Omkar1464/Telemetry-Module-using-CDMA-Modulation/UPDATE_REPORT_FILES/this is the two output from Arduino why there are... (1).docx

Based on your diagram and the typical structure of GPS signals, your Arduino is generating two outputs to simulate the way real GPS satellites communicate.

The two outputs represent the C/A (Coarse/Acquisition) Code and a Data Signal, each serving a different purpose in the CDMA system:

### 1. Output 1: GPS Data (Ranging/Acquisition)

- Code Length: 1000 chips (Your note says 1000; in standard GPS, this is exactly 1023 chips).
- Purpose: This is the "Spreading Code" used for satellite identification and distance measurement.
- Why the length is 1000? A longer code length provides higher Processing Gain. This allows the receiver to pick up the very weak GPS signal from background noise. It also allows the receiver to distinguish between different satellites using the same frequency (CDMA).

### 2. Output 2: Navigation Message (Data Rate)

- Code Length: 10 to 100 chips.
- Data Rate: 100 Hz (or 50 Hz in standard legacy GPS).
- Purpose: This carries the actual Navigation Message (the satellite’s location, time, and health).
- Why it is different? You cannot send the complex 1000-chip ranging code and the actual data at the same speed. The data rate is kept low (100 Hz) to ensure it is extremely reliable and easy to decode once the receiver has "locked onto" the faster 1000-chip ranging signal.

### Comparison of the Two Outputs

Feature | Output 1 (Ranging) | Output 2 (Data)
Code Length | ~1000 chips | ~10-100 chips
Speed | Very Fast (1.023 MHz standard) | Slow (50-100 Hz)
Main Job | Identify "Which Satellite?" and "How far?" | Tell "Where is the satellite?"
Analogy | The "Static" or "ID Card" of the satellite. | The actual "Letter" or "Message" being sent.

### Why have two at all?

In CDMA, you need the high-speed code to spread the signal across a wide bandwidth (making it resistant to interference). You need the low-speed data because trying to send complex information at MHz speeds over thousands of miles would require too much power and would be prone to errors.

Would you like me to help you refine the Arduino code to ensure these two signals are properly synchronized?
