Omkar1464/Telemetry-Module-using-CDMA-Modulation/UPDATE_REPORT_FILES/G48- Update-LO Simulation _20260129_132546_0000.pdf

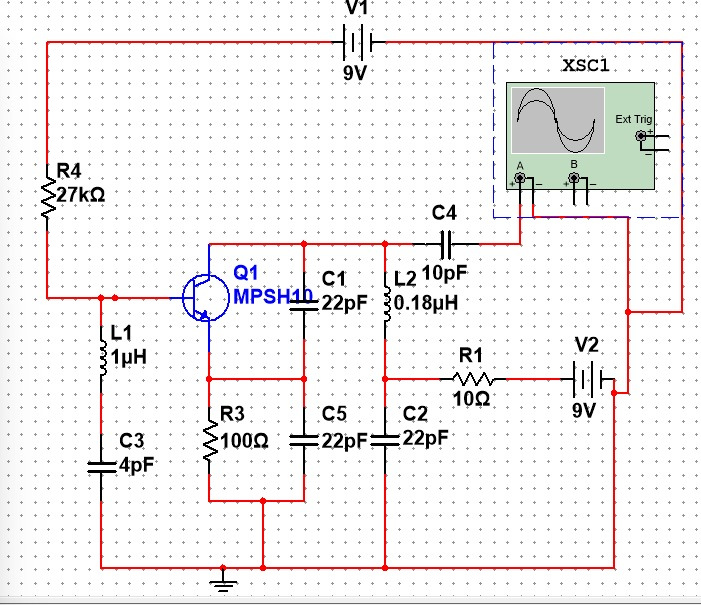
[picture p2: figure]

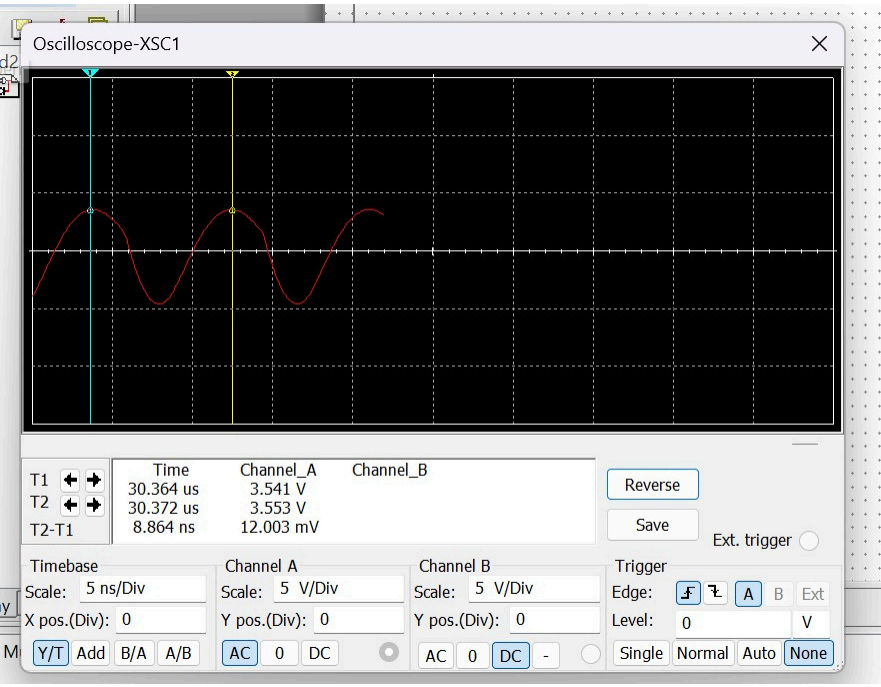
[picture p3: figure]
