Omkar1464/Telemetry-Module-using-CDMA-Modulation/BF998 MOSFET LIB/BF998.step

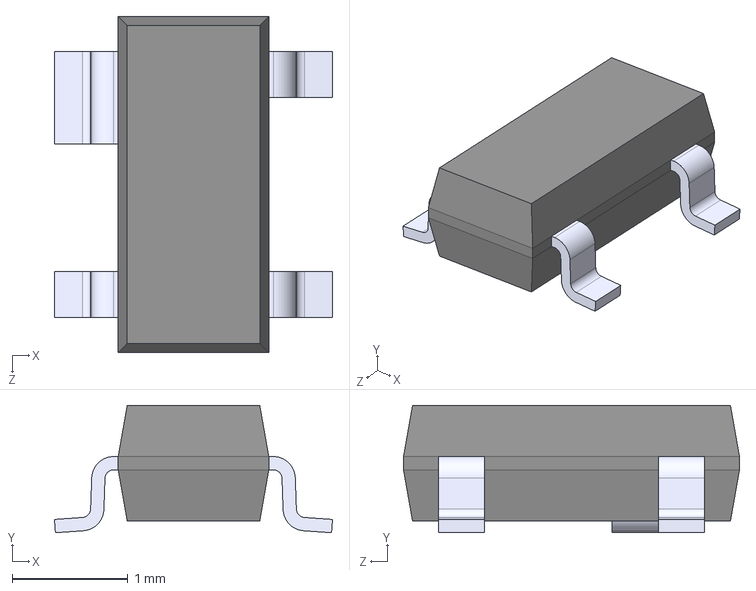
[picture p4: CAD file, 2026-02-17]
BF998 MOSFET LIB/BF998.step
2.40 x 1.10 x 2.90 mm
