Omkar1464/Telemetry-Module-using-CDMA-Modulation/PCB/POWER_MICROCONTROLLER/power circuit _new/MT3608/MT3608.step

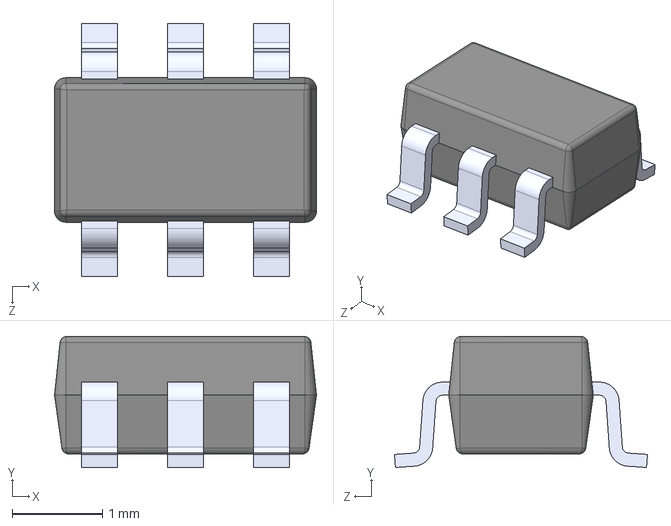
[picture p5: CAD file, 2026-10-12]
PCB/POWER_MICROCONTROLLER/power circuit _new/MT3608/MT3608.step
2.90 x 1.45 x 2.80 mm
