Omkar1464/Telemetry-Module-using-CDMA-Modulation/PCB/POWER_MICROCONTROLLER/power circuit _new/STM32G071RBT6/STM32G071RBT6.step

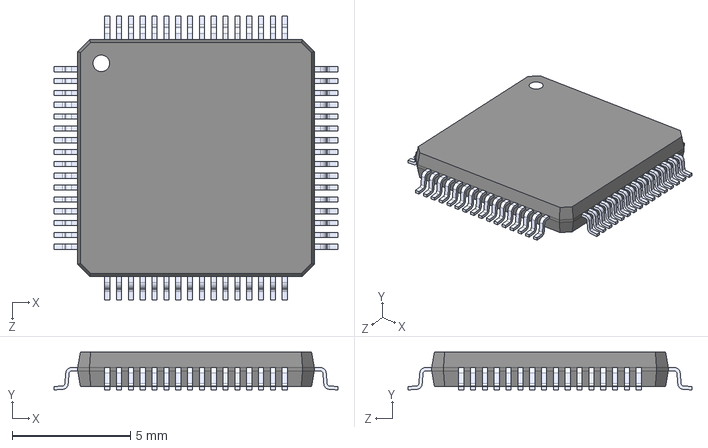
[picture p6: CAD file, 2026-10-12]
PCB/POWER_MICROCONTROLLER/power circuit _new/STM32G071RBT6/STM32G071RBT6.step
12.0 x 1.60 x 12.0 mm
