Omkar1464/Telemetry-Module-using-CDMA-Modulation/(list of files, drawings)

Other design files:
d2.ms14
Design1.ms14
L_oscillator.ms14
