Omkar1464/Telemetry-Module-using-CDMA-Modulation/PCB/POWER_MICROCONTROLLER/power circuit _new/power circuit _new.kicad_pcb

## KiCad design PCB/POWER_MICROCONTROLLER/power circuit _new/power circuit _new.kicad_pcb (2026-10-12)

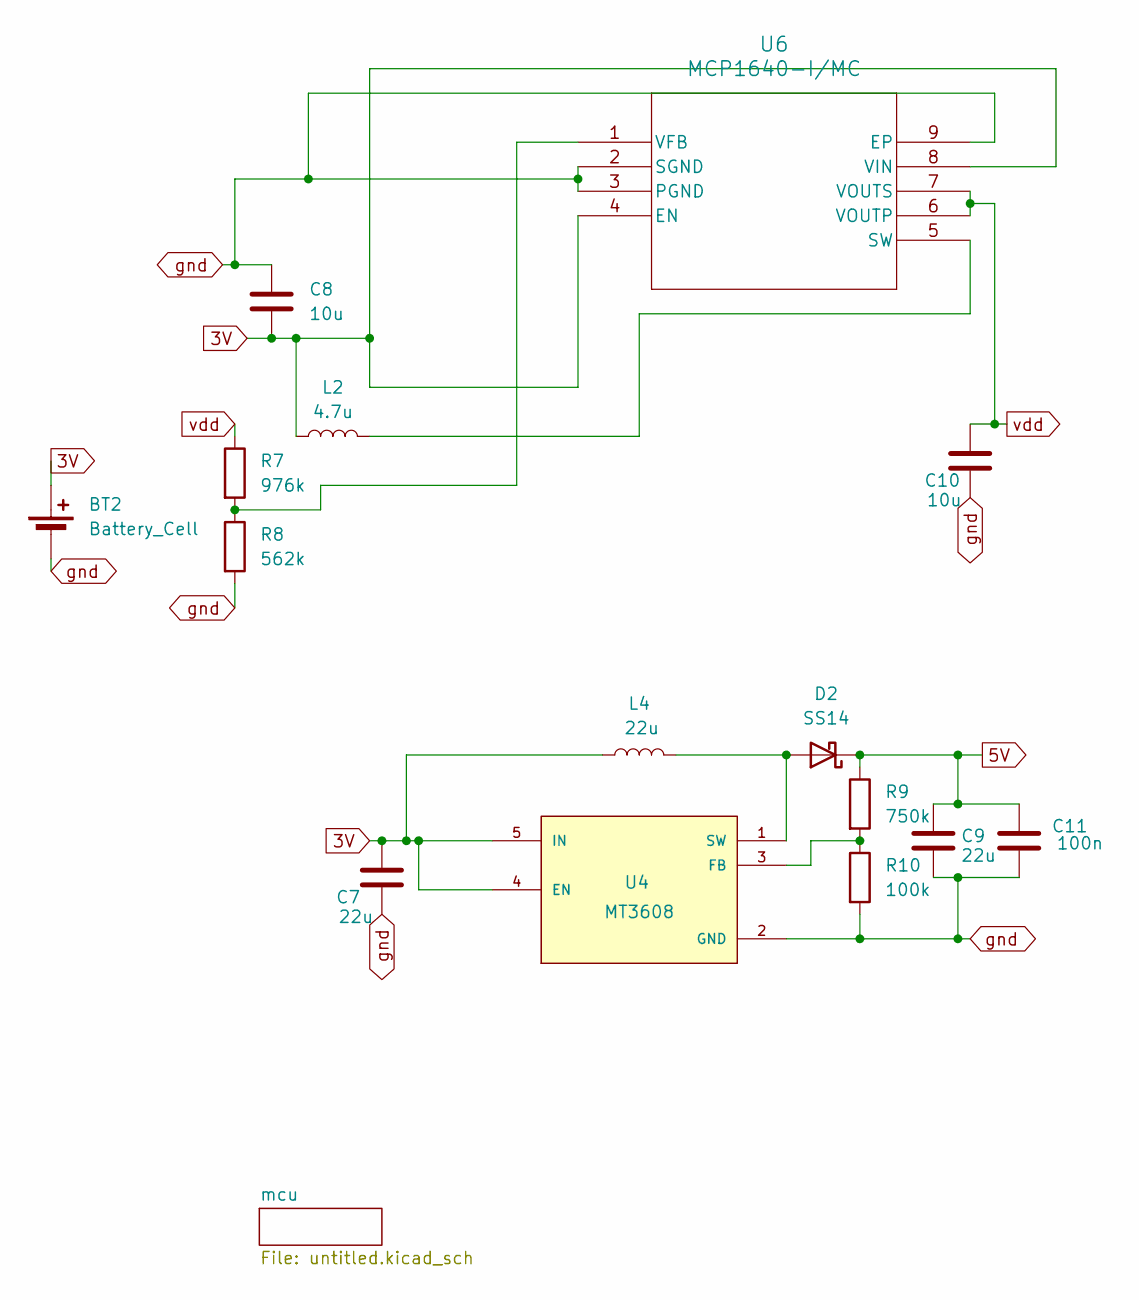
[picture p7: schematic power circuit _new.kicad_sch]

Parts:
BT2: Battery_Cell; SolderWire-0.25sqmm_1x02_P4.2mm_D0.65mm_OD1.7mm_Relief2x
C7, C9: 22u; C_0603_1608Metric
C8, C10: 10u; C_0603_1608Metric
C11: 100n; C_0603_1608Metric
D2: SS14; D_SMA
L2: 4.7u; L_0603_1608Metric
L4: 22u; L_0603_1608Metric
R7: 976k; R_0603_1608Metric
R8: 562k; R_0603_1608Metric
R9: 750k; R_0603_1608Metric
R10: 100k; R_0603_1608Metric
U4: MT3608; SOT95P280X145-6N; PARTREV 1.0
U6: MCP1640-I/MC; DFN8_2x3MC_MCH

Connections:
3V: BT2.1 (+), C7.1, C8.1, L2.1, L4.1, U4.4 (EN), U4.5 (IN), U6.4 (EN), U6.8 (VIN)
5V: C9.1, C11.1, D2.1 (K), R9.1
unnamed: D2.2 (A), L4.2, U4.1 (SW)
unnamed: R9.2, R10.1, U4.3 (FB)
unnamed: L2.2, U6.5 (SW)
unnamed: R7.2, R8.1, U6.1 (VFB)
gnd: BT2.2 (-), C7.2, C8.2, C9.2, C10.2, C11.2, R8.2, R10.2, U4.2 (GND), U6.2 (SGND), U6.3 (PGND), U6.9 (EP); also elsewhere on the board
vdd: C10.1, R7.1, U6.6 (VOUTP), U6.7 (VOUTS); also elsewhere on the board

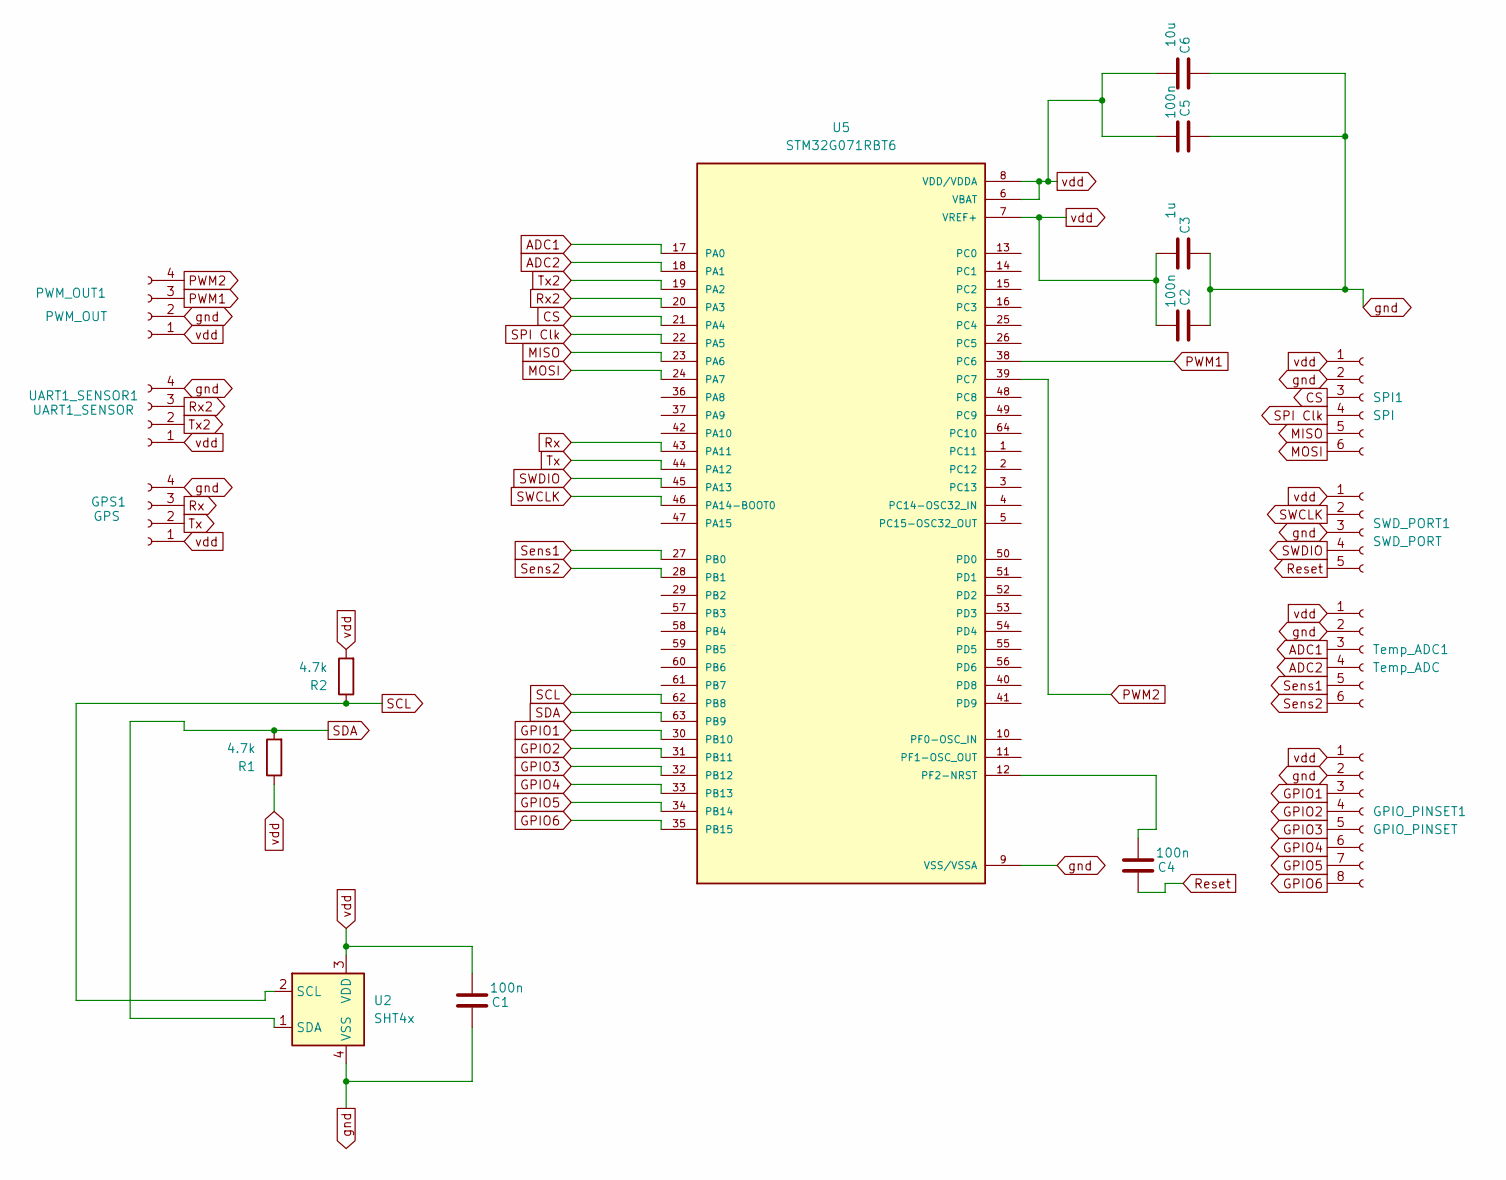
[picture p8: schematic untitled.kicad_sch]

Parts:
C1, C2, C4, C5: 100n; C_0603_1608Metric
C3: 1u; C_0603_1608Metric
C6: 10u; C_0603_1608Metric
GPIO_PINSET1: GPIO_PINSET; PinSocket_1x08_P2.54mm_Vertical
GPS1: GPS; PinSocket_1x04_P2.54mm_Vertical
PWM_OUT1: PWM_OUT; PinSocket_1x04_P2.54mm_Vertical
R1, R2: 4.7k; R_0603_1608Metric
SPI1: SPI; PinSocket_1x06_P2.54mm_Vertical
SWD_PORT1: SWD_PORT; PinSocket_1x05_P2.54mm_Vertical
Temp_ADC1: Temp_ADC; PinSocket_1x06_P2.54mm_Vertical
U2: SHT4x; Sensirion_DFN-4_1.5x1.5mm_P0.8mm_SHT4x_NoCentralPad
U5: STM32G071RBT6; LQFP-64_7x7mm_P0.4mm; PARTREV 2
UART1_SENSOR1: UART1_SENSOR; PinSocket_1x04_P2.54mm_Vertical

Connections:
ADC1: Temp_ADC1.3, U5.17 (PA0)
ADC2: Temp_ADC1.4, U5.18 (PA1)
CS: SPI1.3, U5.21 (PA4)
GPIO1: GPIO_PINSET1.3, U5.30 (PB10)
GPIO2: GPIO_PINSET1.4, U5.31 (PB11)
GPIO3: GPIO_PINSET1.5, U5.32 (PB12)
GPIO4: GPIO_PINSET1.6, U5.33 (PB13)
GPIO5: GPIO_PINSET1.7, U5.34 (PB14)
GPIO6: GPIO_PINSET1.8, U5.35 (PB15)
MISO: SPI1.5, U5.23 (PA6)
MOSI: SPI1.6, U5.24 (PA7)
unnamed: C4.2, U5.12 (PF2-NRST)
PWM1: PWM_OUT1.3, U5.38 (PC6)
PWM2: PWM_OUT1.4, U5.39 (PC7)
Reset: C4.1, SWD_PORT1.5
Rx: GPS1.3, U5.43 (PA11)
Rx2: U5.20 (PA3), UART1_SENSOR1.3
SCL: R2.1, U2.2 (SCL), U5.62 (PB8)
SDA: R1.2, U2.1 (SDA), U5.63 (PB9)
SPI Clk: SPI1.4, U5.22 (PA5)
SWCLK: SWD_PORT1.2, U5.46 (PA14-BOOT0)
SWDIO: SWD_PORT1.4, U5.45 (PA13)
Sens1: Temp_ADC1.5, U5.27 (PB0)
Sens2: Temp_ADC1.6, U5.28 (PB1)
Tx: GPS1.2, U5.44 (PA12)
Tx2: U5.19 (PA2), UART1_SENSOR1.2
gnd: C1.1, C2.1, C3.1, C5.1, C6.1, GPIO_PINSET1.2, GPS1.4, PWM_OUT1.2, SPI1.2, SWD_PORT1.3, Temp_ADC1.2, U2.4 (VSS), U5.9 (VSS/VSSA), UART1_SENSOR1.4; also elsewhere on the board
vdd: C1.2, C2.2, C3.2, C5.2, C6.2, GPIO_PINSET1.1, GPS1.1, PWM_OUT1.1, R1.1, R2.2, SPI1.1, SWD_PORT1.1, Temp_ADC1.1, U2.3 (VDD), U5.6 (VBAT), U5.7 (VREF+), U5.8 (VDD/VDDA), UART1_SENSOR1.1; also elsewhere on the board

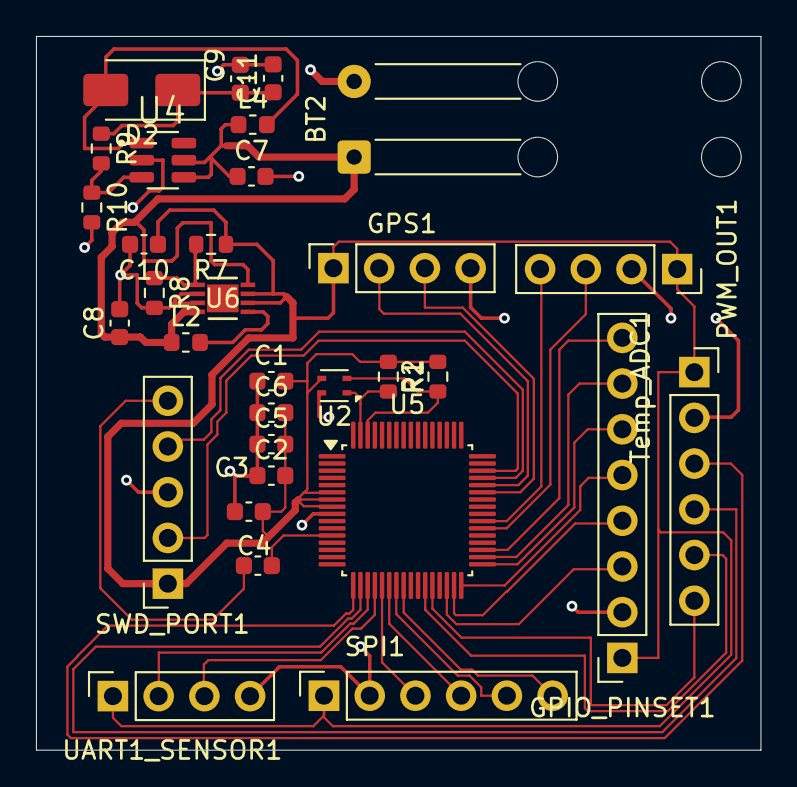
[picture p9: board power circuit _new.kicad_pcb from above]

Board: 2 copper layers, 40.2 x 39.7 mm, 32 parts (0 on the bottom side), 34 nets.
