Omkar1464/Telemetry-Module-using-CDMA-Modulation/UPDATE_REPORT_FILES/tep-by-step process of how the data moves (1).docx

Here is the exact step-by-step process of how the data moves from the NEO-6 GPS to your final CDMA "sign":

### 1. The Fetching Phase (Serial Communication)

The Arduino acts as the brain. It talks to the NEO-6 GPS module using two wires: TX (Transmit) and RX (Receive).¹

- The NEO-6 module sends information like latitude and longitude in a format called NMEA.²
- The Arduino "fetches" this data by reading it character by character from the serial port.³
- For example, it might read the letter "A". In binary, that letter is 01000001.

### 2. The Conversion Phase (Bit Streaming)

To use the XOR logic, the Arduino must take that binary data and "feed" it into the system one bit at a time.

- If your data rate is 100 Hz as per your notes, the Arduino holds onto one bit (like a 0) for exactly 10 milliseconds.

### 3. The XOR "Mixing" Phase

This is where the actual CDMA sign is generated. While the Arduino is holding that single 0 from the GPS, it is also generating your 1000-length code at a much faster rate (100 kHz).

- Step A: Fetch 1 bit from GPS (let's say it's a 0).
- Step B: Fetch 1 chip from your LFSR code generator (let's say it's a 1).
- Step C: Perform the XOR calculation: 0 XOR 1 = 1.
- Step D: Send that 1 to the output pin.

### 4. Why the XOR is necessary for the "Sign"

If you just sent the GPS data alone, it would be too slow to measure distance. If you just sent the 1000-length code alone, there would be no information in the signal.

- The XOR allows the slow data to "hitch a ride" on the fast code.
- This creates the final transmitted sign that contains both the satellite's identity and your actual GPS location data.

### Summary of Data Flow

1. NEO-6 GPS $\rightarrow$ Serial Data (NMEA) $\rightarrow$ Arduino.
2. Arduino $\rightarrow$ Convert to bits $\rightarrow$ XOR Input A.
3. LFSR Generator $\rightarrow$ 1000-length chips $\rightarrow$ XOR Input B.
4. XOR Output $\rightarrow$ Digital Pin (CDMA Sign).

Would you like me to write the Arduino function that specifically converts the GPS serial characters into individual bits for the XOR mixer?
