Omkar1464/Telemetry-Module-using-CDMA-Modulation/GPS-Neo6M/GPS Module No Fix Troubleshoot.xlsx

Message | Meaning | Status in Your Output
$GNGGA | Global Positioning System Fix Data | The 0 indicates No Fix is currently available.
$GNGSA | GNSS DOP and Active Satellites | Empty fields mean no satellites are currently being used for navigation.
$GPGSV | GPS Satellites in View | The 00 indicates zero satellites are currently being tracked with enough strength.
$GNRMC | Recommended Minimum Navigation Info | The V stands for Void (invalid data/no fix).
